Slenderman00/ethernet4pizero-poe/ice4pi.kicad_pcb

## KiCad design ice4pi.kicad_pcb (2025-01-09)

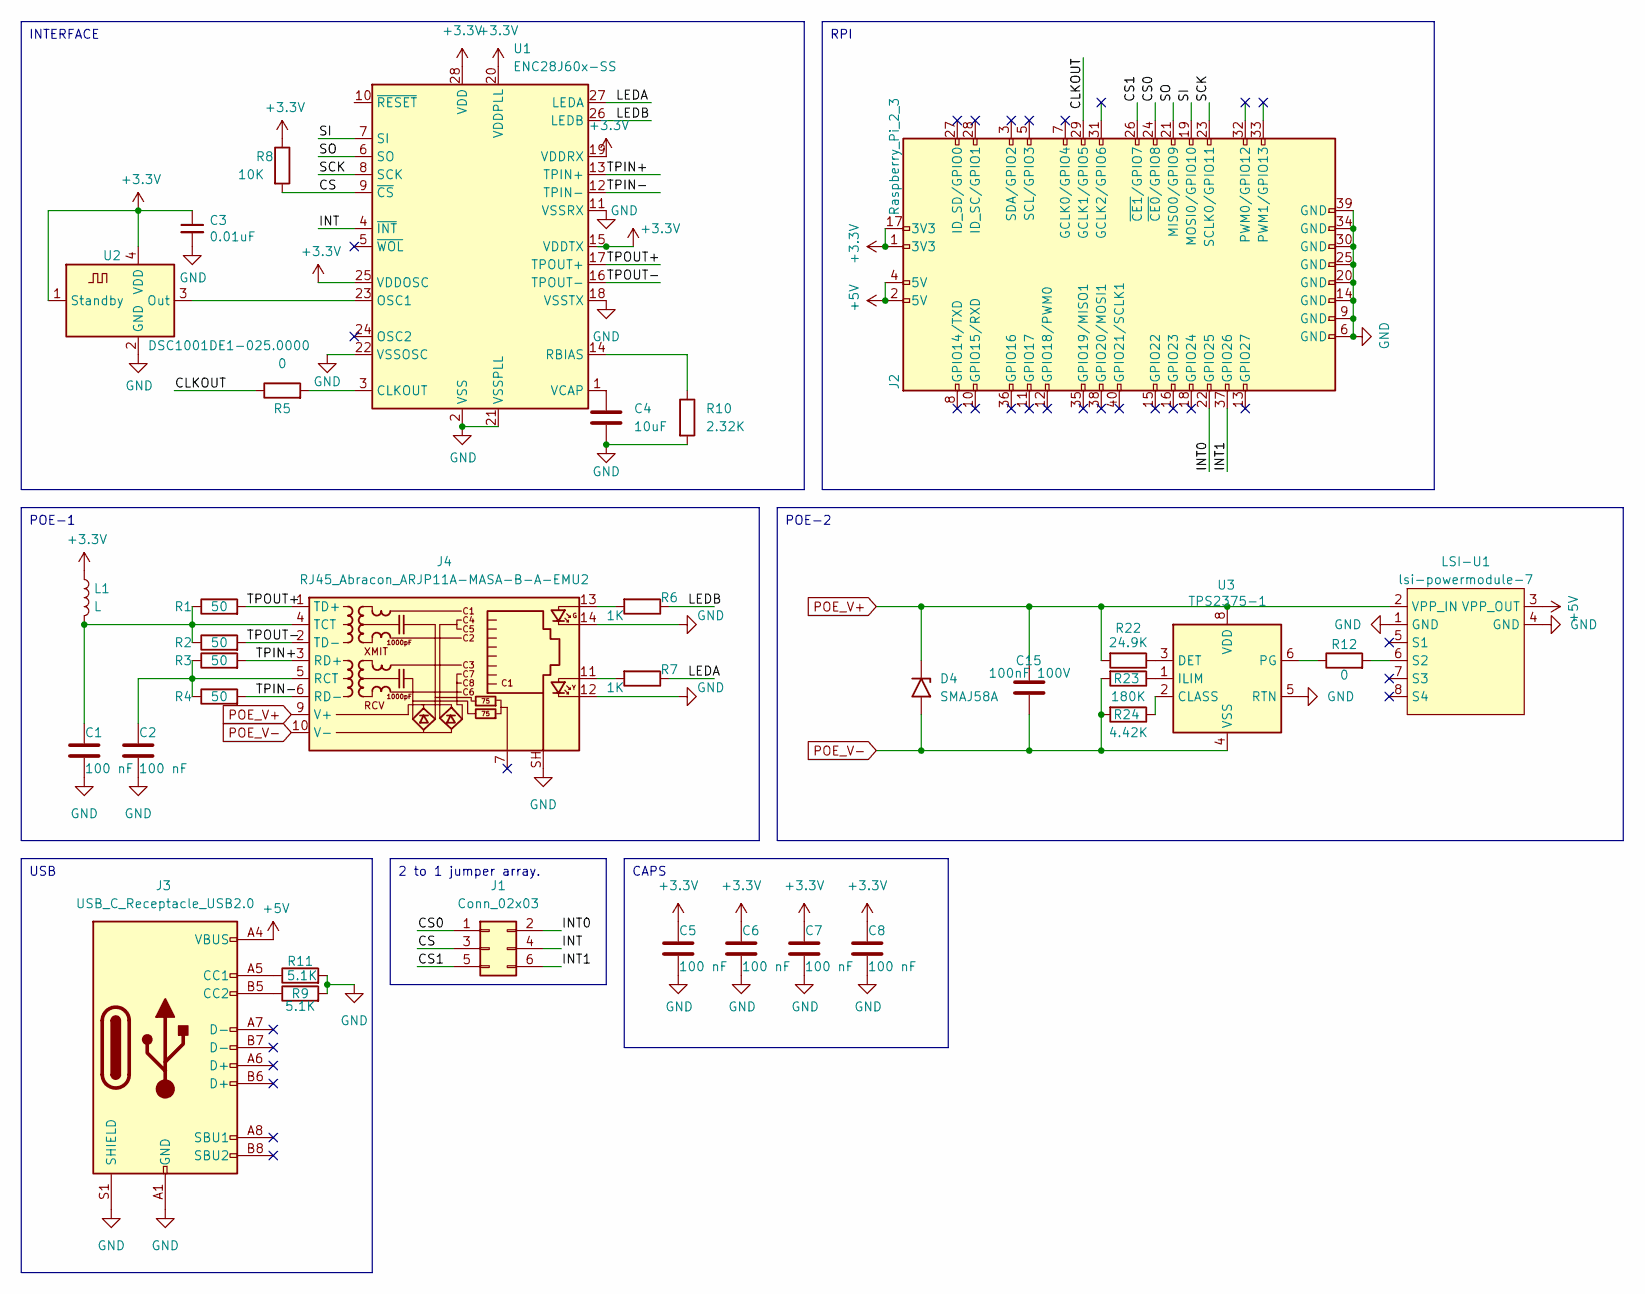
[picture p1: schematic ice4pi.kicad_sch, ethernet4pizero-poe-1.0]

Parts:
C1, C2, C5, C6, C7, C8: 100 nF; C_0402_1005Metric
C3: 0.01uF; C_0402_1005Metric
C4: 10uF; C_0402_1005Metric
C15: 100nF 100V; C_0402_1005Metric
D4: SMAJ58A; D_SMA
J1: Conn_02x03; PinHeader_2x03_P2.54mm_Vertical
J2: Raspberry_Pi_2_3; PinSocket_2x20_P2.54mm_Vertical_1_04mm
J3: USB_C_Receptacle_USB2.0; USB_C_Receptacle_GCT_USB4105-xx-A_16P_TopMnt_Horizontal
J4: RJ45_Abracon_ARJP11A-MASA-B-A-EMU2; RJ45_Abracon_ARJP11A-MA_Horizontal
L1: L; L_1210_3225Metric
LSI-U1: lsi-powermodule-7
R1, R2, R3, R4: 50; R_0402_1005Metric
R5, R12: 0; R_0402_1005Metric
R6, R7: 1K; R_0402_1005Metric
R8: 10K; C_0402_1005Metric
R9, R11: 5.1K; R_0402_1005Metric
R10: 2.32K; R_0402_1005Metric
R22: 24.9K; R_0402_1005Metric
R23: 180K; R_0402_1005Metric
R24: 4.42K; R_0402_1005Metric
U1: ENC28J60x-SS; SSOP-28_5.3x10.2mm_P0.65mm
U2: DSC1001DE1-025.0000; Oscillator_SMD_Abracon_ASDMB-4Pin_2.5x2.0mm
U3: TPS2375-1; TSSOP-8_4.4x3mm_P0.65mm

Connections:
+3.3V: C3.1, C5.1, C6.1, C7.1, C8.1, J2.1 (3V3), J2.17 (3V3), L1.1, R8.1, U1.15 (VDDTX), U1.19 (VDDRX), U1.20 (VDDPLL), U1.25 (VDDOSC), U1.28 (VDD), U2.1 (Standby), U2.4 (VDD)
+5V: J2.2 (5V), J2.4 (5V), J3.A4 (VBUS), J3.A9 (VBUS), J3.B4 (VBUS), J3.B9 (VBUS), LSI-U1.3 (VPP_OUT)
/CLKOUT: J2.29 (GCLK1/GPIO5), R5.1
/CS: J1.3, R8.2, U1.9 (~CS)
/CS0: J1.1, J2.24 (~CE0/GPIO8)
/CS1: J1.5, J2.26 (~CE1/GPIO7)
/INT: J1.4, U1.4 (~INT)
/INT0: J1.2, J2.22 (GPIO25)
/INT1: J1.6, J2.37 (GPIO26)
/LEDA: R7.1, U1.27 (LEDA)
/LEDB: R6.1, U1.26 (LEDB)
/SCK: J2.23 (SCLK0/GPIO11), U1.8 (SCK)
/SI: J2.19 (MOSI0/GPIO10), U1.7 (SI)
/SO: J2.21 (MISO0/GPIO9), U1.6 (SO)
/TPIN+: J4.3 (RD+), R3.2, U1.13 (TPIN+)
/TPIN-: J4.6 (RD-), R4.2, U1.12 (TPIN-)
/TPOUT+: J4.1 (TD+), R1.2, U1.17 (TPOUT+)
/TPOUT-: J4.2 (TD-), R2.2, U1.16 (TPOUT-)
GND: C1.2, C2.2, C3.2, C4.2, C5.2, C6.2, C7.2, C8.2, J2.6 (GND), J2.9 (GND), J2.14 (GND), J2.20 (GND), J2.25 (GND), J2.30 (GND), J2.34 (GND), J2.39 (GND), J3.A1 (GND), J3.A12 (GND), J3.B1 (GND), J3.B12 (GND), J3.S1 (SHIELD), J4.12, J4.14, J4.SH, LSI-U1.1 (GND), LSI-U1.4 (GND), R9.2, R10.2, R11.2, U1.2 (VSS), U1.11 (VSSRX), U1.18 (VSSTX), U1.21 (VSSPLL), U1.22 (VSSOSC), U2.2 (GND), U3.5 (RTN)
unnamed: J3.A5 (CC1), R11.1
unnamed: J3.B5 (CC2), R9.1
unnamed: J4.11, R7.2
unnamed: J4.13, R6.2
unnamed: C2.1, J4.5 (RCT), R3.1, R4.1
unnamed: C1.1, J4.4 (TCT), L1.2, R1.1, R2.1
unnamed: LSI-U1.6 (S2), R12.2
unnamed: R5.2, U1.3 (CLKOUT)
unnamed: U1.23 (OSC1), U2.3 (Out)
unnamed: R10.1, U1.14 (RBIAS)
unnamed: C4.1, U1.1 (VCAP)
unnamed: R24.1, U3.2 (CLASS)
unnamed: R22.1, U3.3 (DET)
unnamed: R23.1, U3.1 (ILIM)
unnamed: R12.1, U3.6 (PG)
POE_V+: C15.1, D4.1 (A1), J4.9 (V+), LSI-U1.2 (VPP_IN), R22.2, U3.8 (VDD)
POE_V-: C15.2, D4.2 (A2), J4.10 (V-), R23.2, R24.2, U3.4 (VSS)

Notes on the sheet:
INTERFACE
RPI
POE-2
CAPS
POE-1
USB
2 to 1 jumper array.

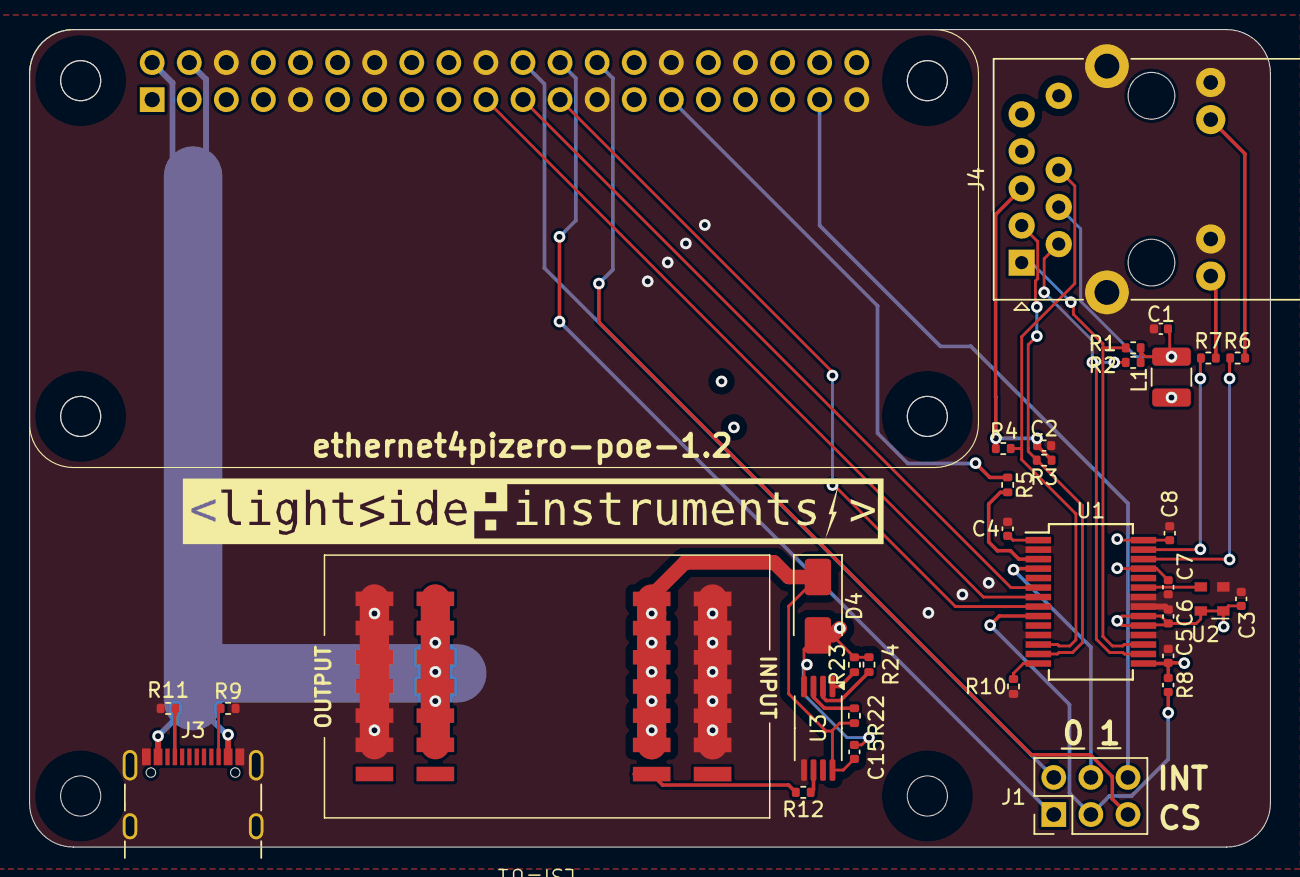
[picture p2: board ice4pi.kicad_pcb from above]

Board: 4 copper layers, 85.0 x 56.0 mm, 35 parts (1 on the bottom side), 36 nets.

Other parts of the board:
svg2mod: G***; lsi-logo-48mm
