Slenderman00/ethernet4pizero-poe/(commit log)

2024-07-25 feat: poe
    [ice4pi.kicad_pcb, ice4pi.kicad_sch]
2024-07-25 feat: commit 2
    [ice4pi.kicad_sch]
2024-07-26 feat: poe controller
    [ice4pi.kicad_pcb, ice4pi.kicad_sch]
2024-07-26 feat: finished poe-1.0
    [ice4pi.kicad_pcb]
2024-07-26 fix: added resistor
    [ice4pi.kicad_pcb, ice4pi.kicad_sch]
2024-07-26 feat: pos.csv
    [ice4pi-B_Cu.gbr, ice4pi-B_Mask.gbr, ice4pi-B_Paste.gbr, ice4pi-B_Silkscreen.gbr, ice4pi-Edge_Cuts.gbr, ice4pi-F_Cu.gbr, ice4pi-F_Mask.gbr, ice4pi-F_Paste.gbr]
2024-08-01 fix: poe_v- trace width
    [ice4pi.kicad_pcb]
2024-09-20 fix: fixed powermod footprint
    [ice4pi.kicad_pcb]
2024-11-07 fix: no thermal reliefs
    [ice4pi.kicad_pcb]
2024-11-07 fix: better paths
    [ice4pi.kicad_pcb]
2024-11-07 fix: led
    [ice4pi.kicad_pcb, ice4pi.kicad_sch]
2024-11-11 feat: changed power traces layer
    [ice4pi.kicad_pcb]
2024-11-11 fix: using correct powermod footprint
    [ice4pi.kicad_pcb]
2024-11-11 fix: fixed led polarity
    [ice4pi.kicad_pcb, ice4pi.kicad_sch]
2024-11-11 fix: cosmetics
    [ice4pi.kicad_sch]
2024-11-25 todo: fix led polarity
    [ice4pi.kicad_sch]
2025-01-09 fix: powergood is an open drain
    [ice4pi.kicad_sch]
2025-01-09 feat: fixed led polarity
    [ice4pi.kicad_pcb, ice4pi.kicad_sch]
